ChordSense/ChordSense/docs/AI-rendered-chordsense.png

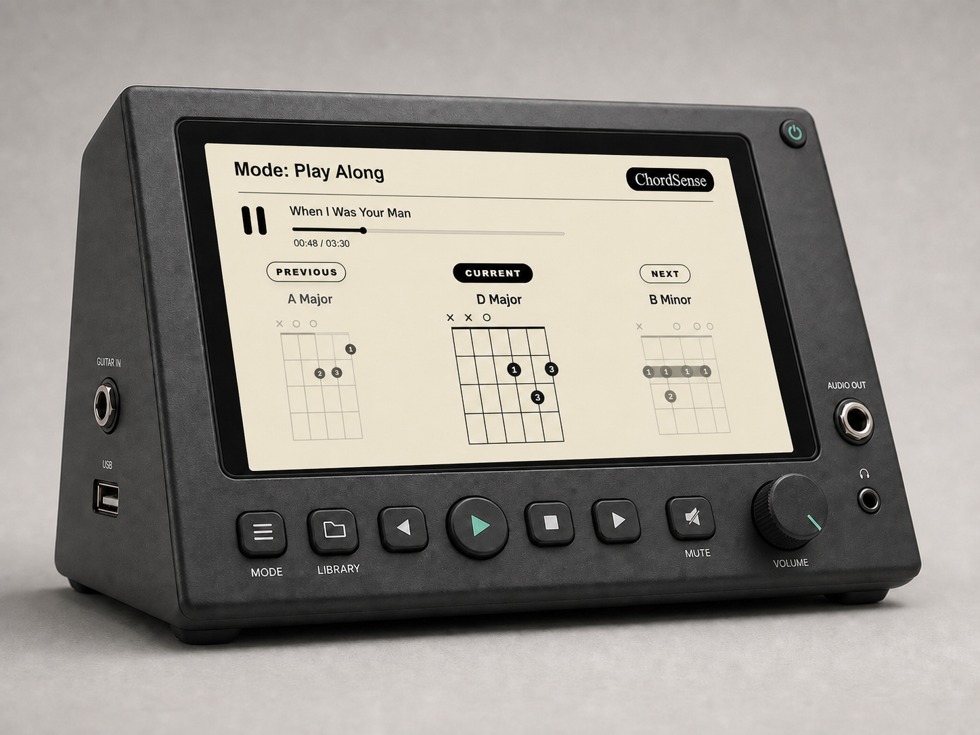
docs/AI-rendered-chordsense.png
