ChordSense/ChordSense/backend/models/chordsense_cnn/notebooks/confusion_matrix.png

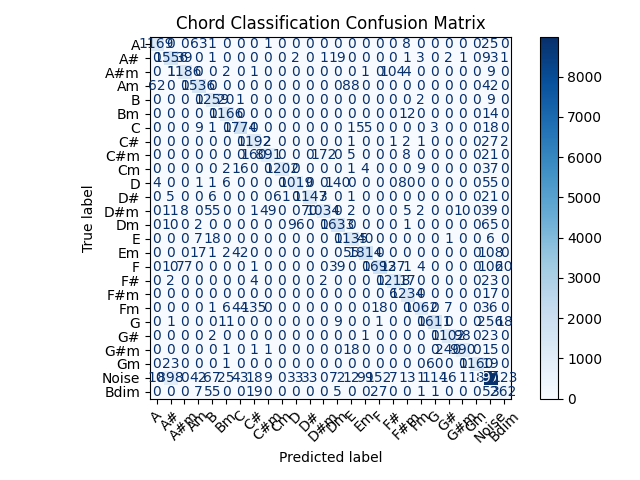
backend/models/chordsense_cnn/notebooks/confusion_matrix.png
