ChordSense/ChordSense/device-ui/src/assets/chords/a.png

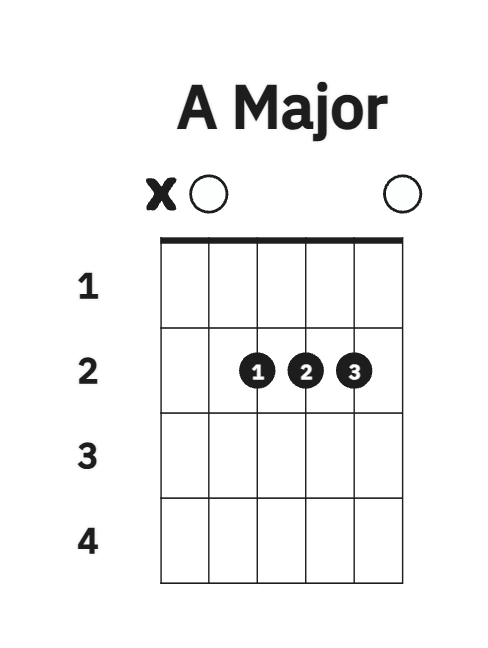
device-ui/src/assets/chords/a.png
