ChordSense/ChordSense/device-ui/src/assets/chords/abmaj7.png

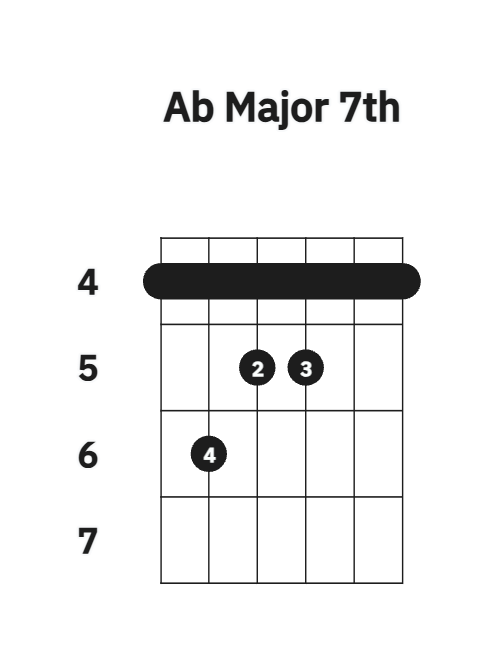
device-ui/src/assets/chords/abmaj7.png
