ChordSense/ChordSense/device-ui/src/assets/chords/b7.png

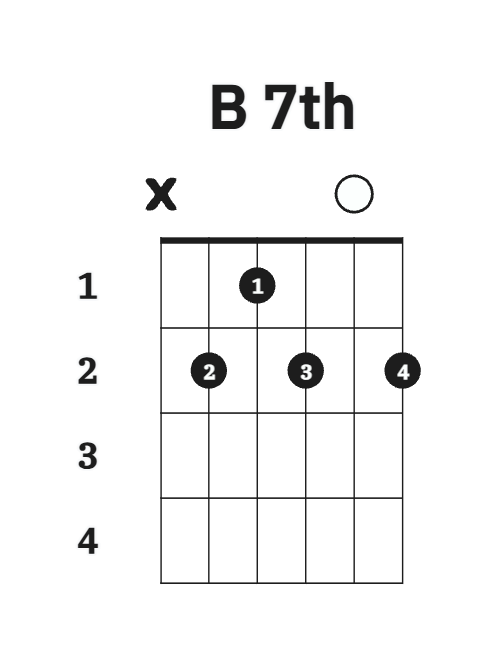
device-ui/src/assets/chords/b7.png
