ChordSense/ChordSense/device-ui/src/assets/chords/bb7.png

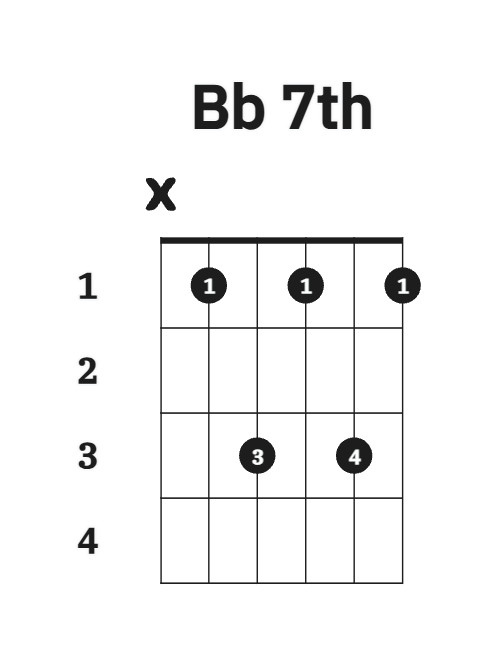
device-ui/src/assets/chords/bb7.png
