ChordSense/ChordSense/device-ui/src/assets/chords/bm.png

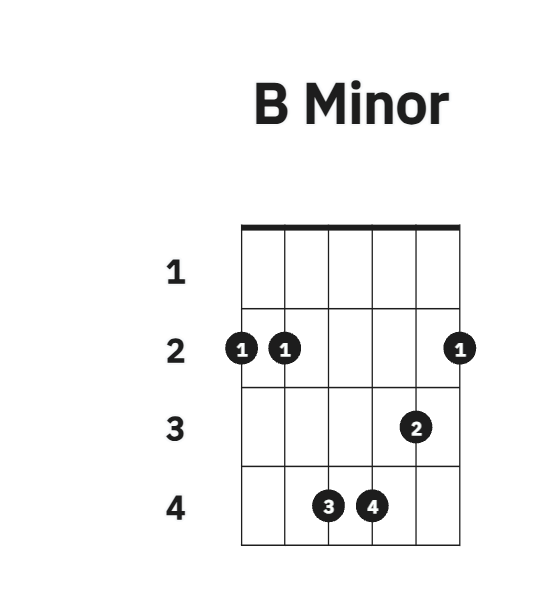
device-ui/src/assets/chords/bm.png
