ChordSense/ChordSense/device-ui/src/assets/chords/c7.png

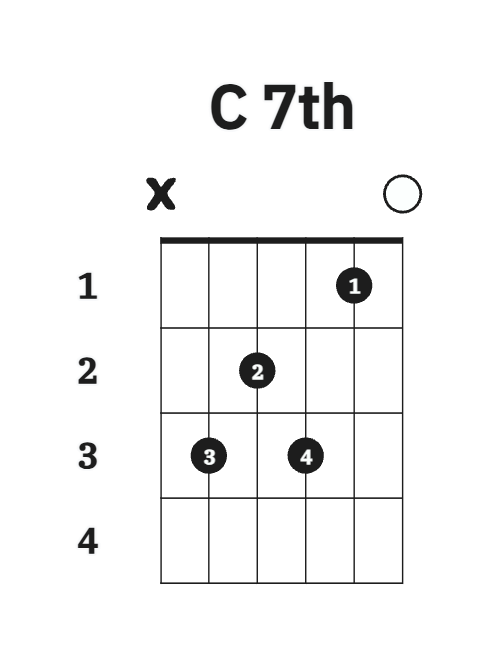
device-ui/src/assets/chords/c7.png
