ChordSense/ChordSense/device-ui/src/assets/chords/csharp.png

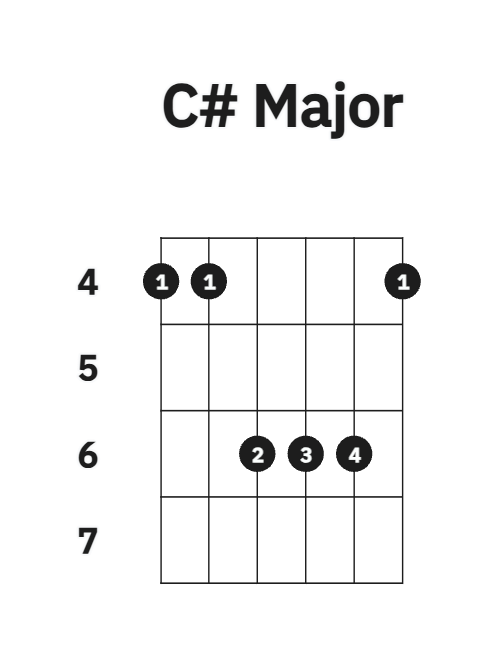
device-ui/src/assets/chords/csharp.png
