ChordSense/ChordSense/device-ui/src/assets/chords/csharpm.png

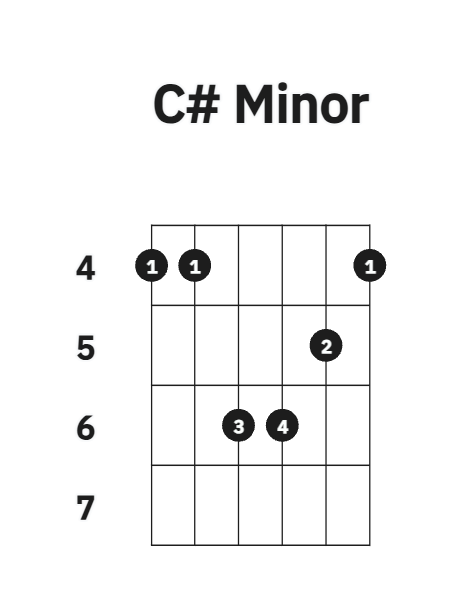
device-ui/src/assets/chords/csharpm.png
