ChordSense/ChordSense/device-ui/src/assets/chords/csharpmaj7.png

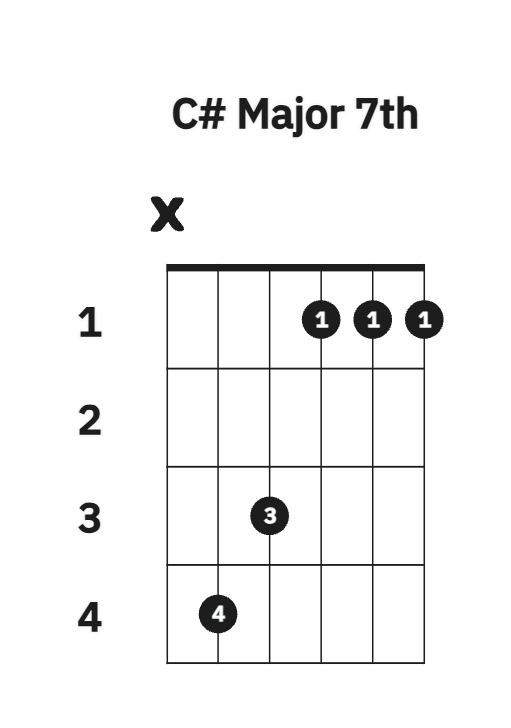
device-ui/src/assets/chords/csharpmaj7.png
