ChordSense/ChordSense/device-ui/src/assets/chords/d7.png

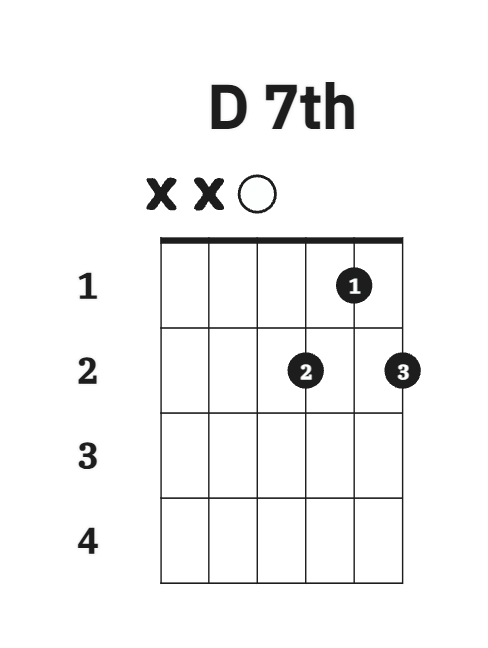
device-ui/src/assets/chords/d7.png
