ChordSense/ChordSense/device-ui/src/assets/chords/dm7.png

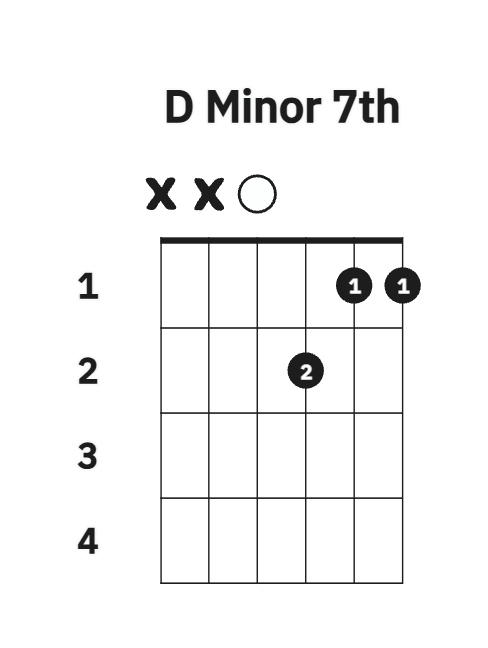
device-ui/src/assets/chords/dm7.png
