ChordSense/ChordSense/device-ui/src/assets/chords/e.png

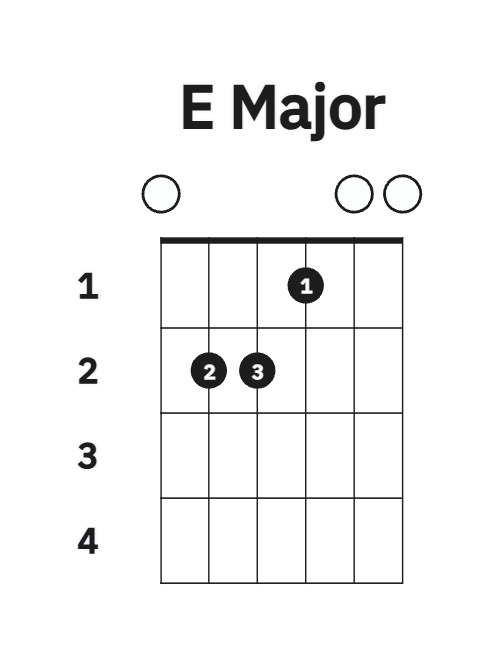
device-ui/src/assets/chords/e.png
