ChordSense/ChordSense/device-ui/src/assets/chords/eb.png

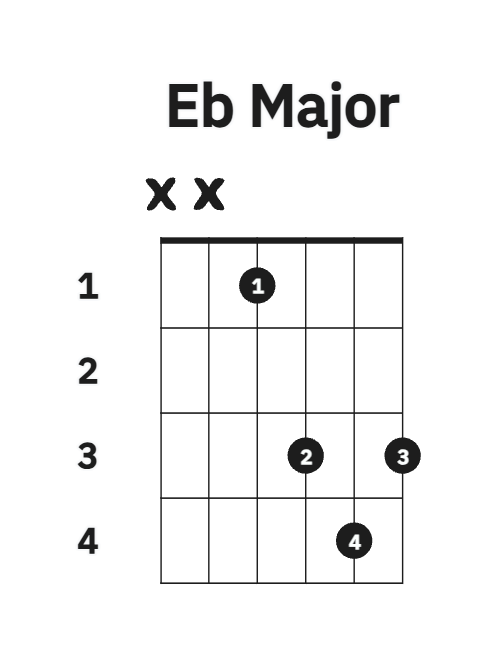
device-ui/src/assets/chords/eb.png
