ChordSense/ChordSense/device-ui/src/assets/chords/ebmaj7.png

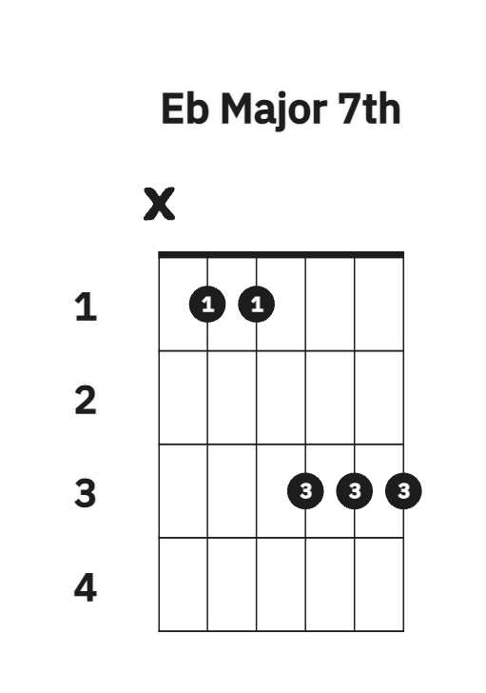
device-ui/src/assets/chords/ebmaj7.png
