ChordSense/ChordSense/device-ui/src/assets/chords/fm.png

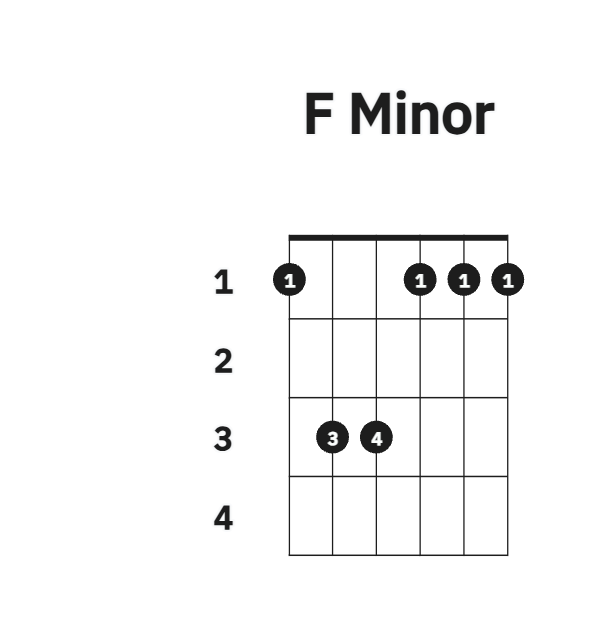
device-ui/src/assets/chords/fm.png
