ChordSense/ChordSense/device-ui/src/assets/chords/fmaj7.png

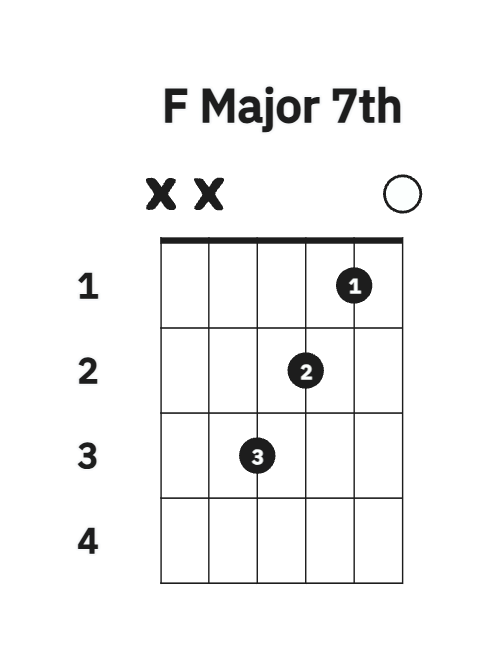
device-ui/src/assets/chords/fmaj7.png
