ChordSense/ChordSense/device-ui/src/assets/chords/g7.png

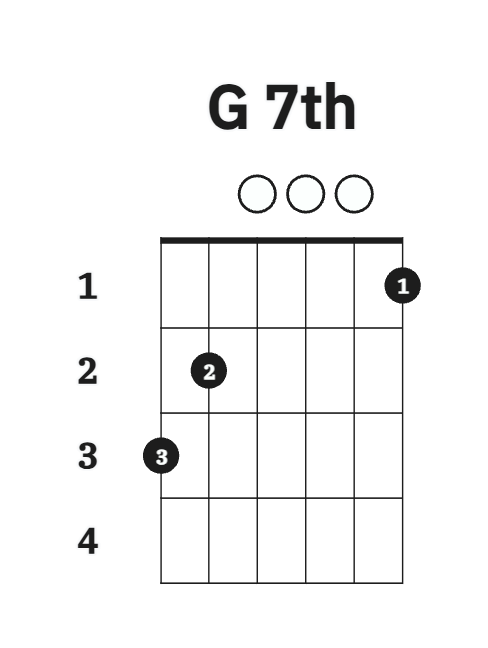
device-ui/src/assets/chords/g7.png
