ChordSense/ChordSense/frontend-tauri/frontend-tauri/src/assets/chords/a7.png

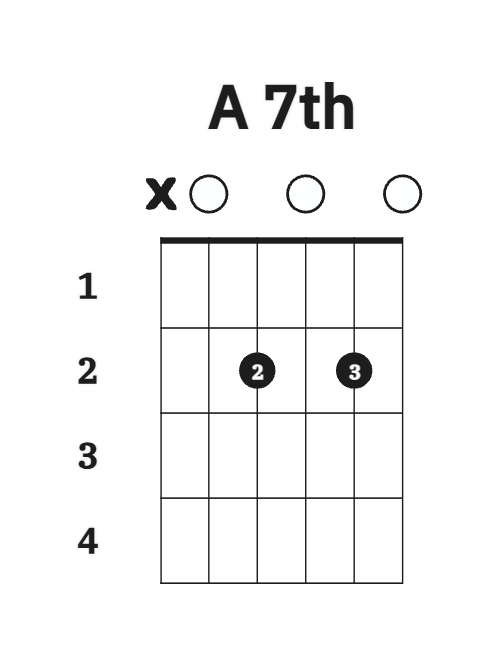
frontend-tauri/frontend-tauri/src/assets/chords/a7.png
