ChordSense/ChordSense/frontend-tauri/frontend-tauri/src/assets/chords/ab7.png

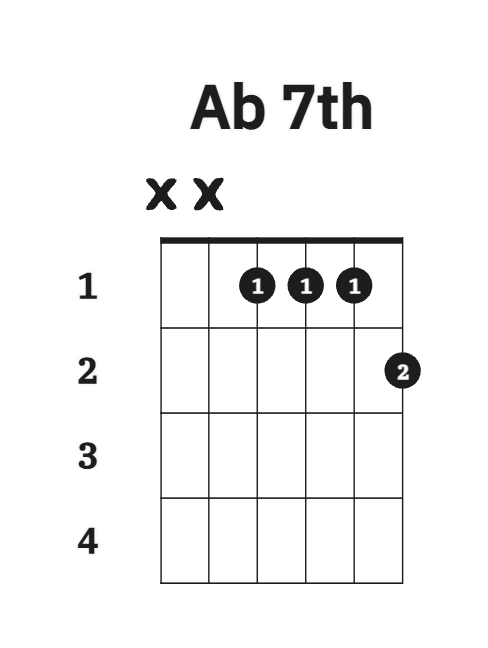
frontend-tauri/frontend-tauri/src/assets/chords/ab7.png
