ChordSense/ChordSense/frontend-tauri/frontend-tauri/src/assets/chords/ab.png

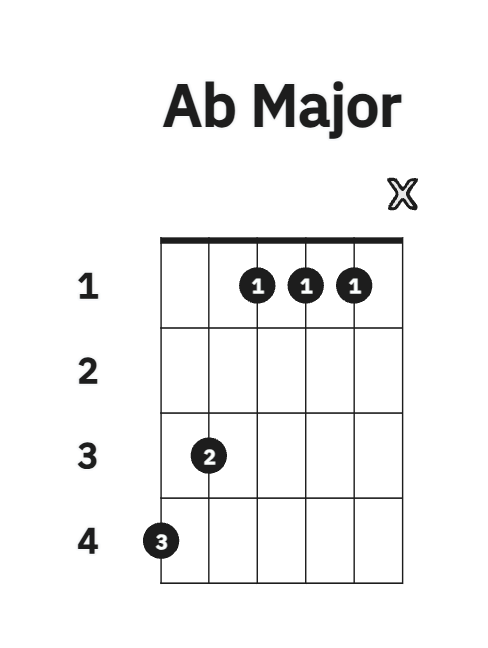
frontend-tauri/frontend-tauri/src/assets/chords/ab.png
