ChordSense/ChordSense/frontend-tauri/frontend-tauri/src/assets/chords/abm7.png

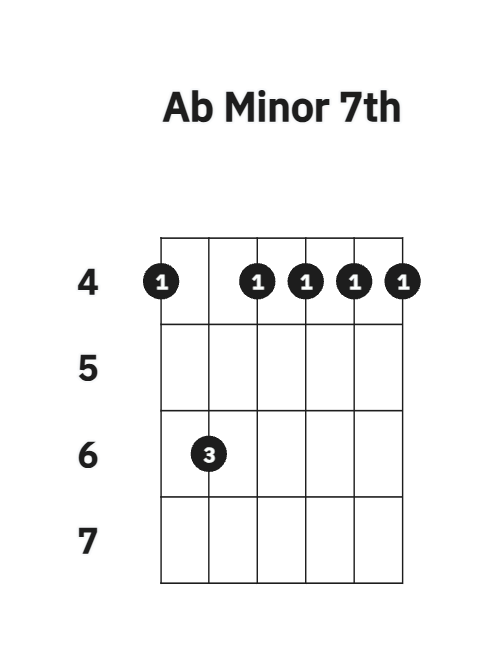
frontend-tauri/frontend-tauri/src/assets/chords/abm7.png
