ChordSense/ChordSense/frontend-tauri/frontend-tauri/src/assets/chords/abm.png

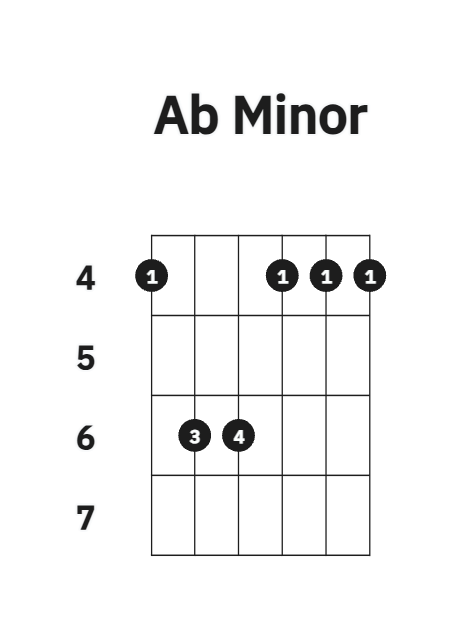
frontend-tauri/frontend-tauri/src/assets/chords/abm.png
