ChordSense/ChordSense/frontend-tauri/frontend-tauri/src/assets/chords/am7.png

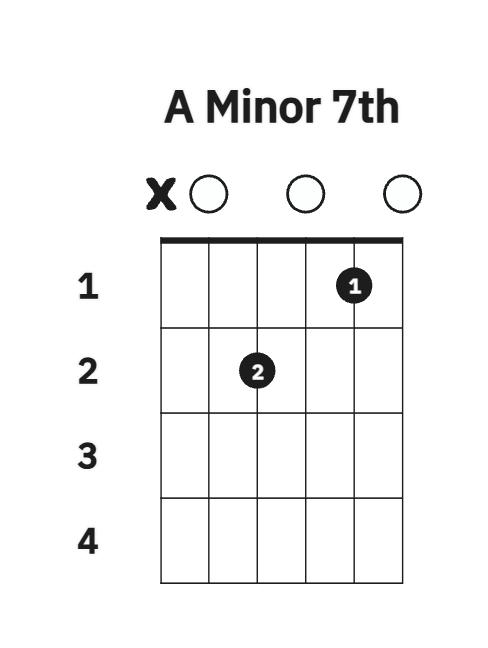
frontend-tauri/frontend-tauri/src/assets/chords/am7.png
