ChordSense/ChordSense/frontend-tauri/frontend-tauri/src/assets/chords/am.png

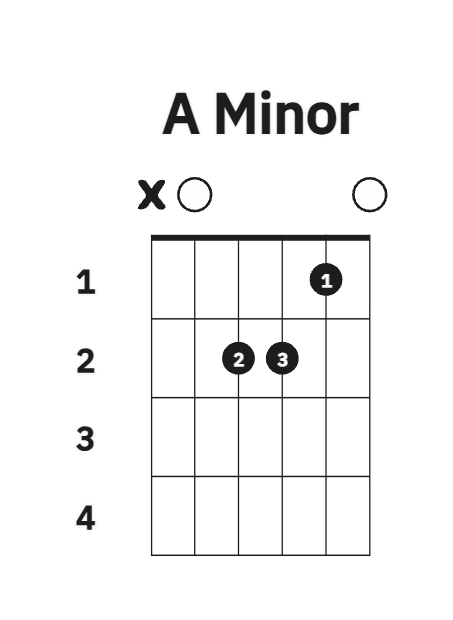
frontend-tauri/frontend-tauri/src/assets/chords/am.png
