ChordSense/ChordSense/frontend-tauri/frontend-tauri/src/assets/chords/amaj7.png

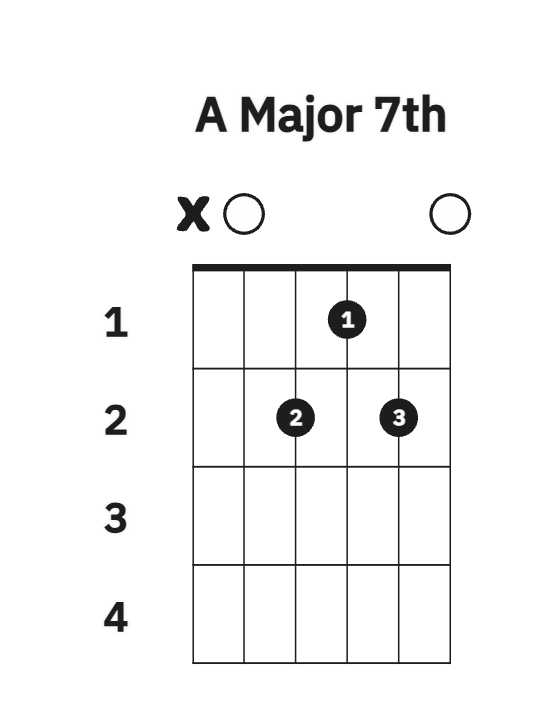
frontend-tauri/frontend-tauri/src/assets/chords/amaj7.png
