ChordSense/ChordSense/frontend-tauri/frontend-tauri/src/assets/chords/b.png

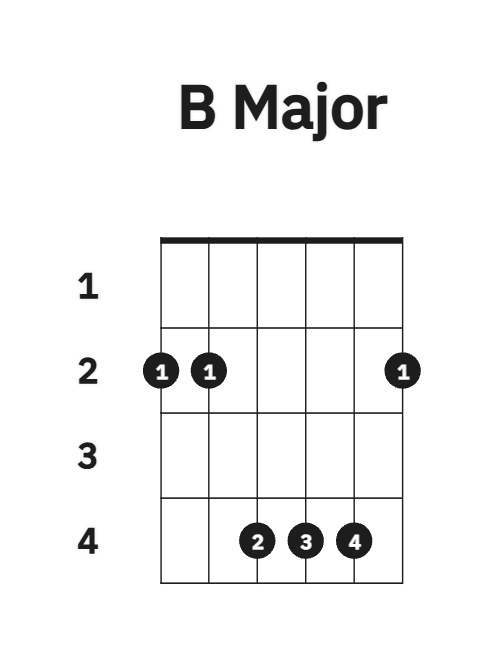
frontend-tauri/frontend-tauri/src/assets/chords/b.png
