ChordSense/ChordSense/frontend-tauri/frontend-tauri/src/assets/chords/bbm7.png

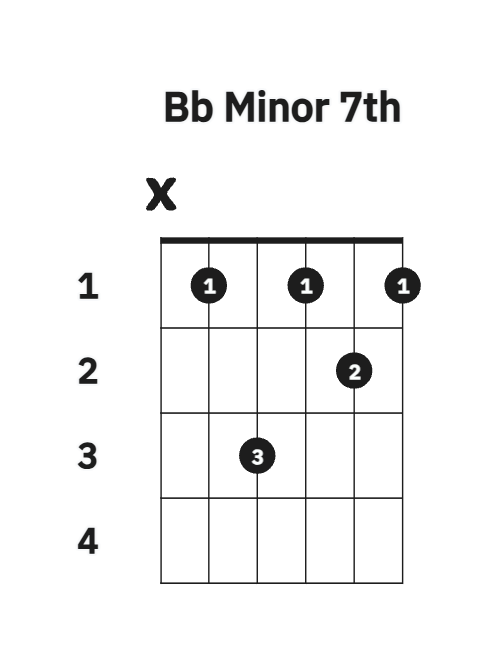
frontend-tauri/frontend-tauri/src/assets/chords/bbm7.png
