ChordSense/ChordSense/frontend-tauri/frontend-tauri/src/assets/chords/bbm.png

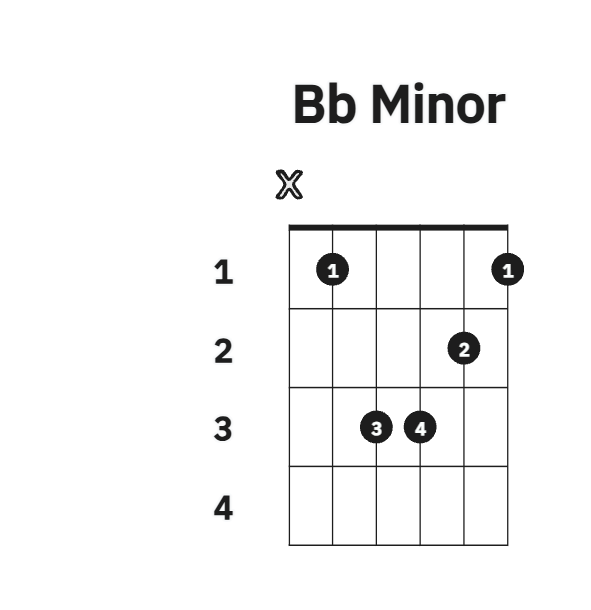
frontend-tauri/frontend-tauri/src/assets/chords/bbm.png
