ChordSense/ChordSense/frontend-tauri/frontend-tauri/src/assets/chords/bm7.png

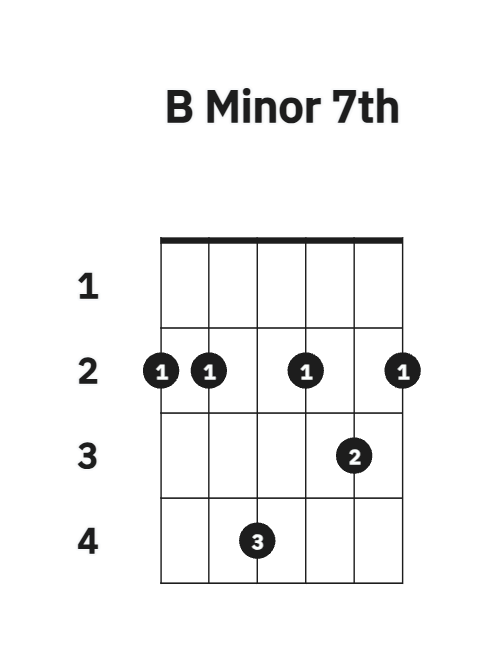
frontend-tauri/frontend-tauri/src/assets/chords/bm7.png
