ChordSense/ChordSense/frontend-tauri/frontend-tauri/src/assets/chords/bmaj7.png

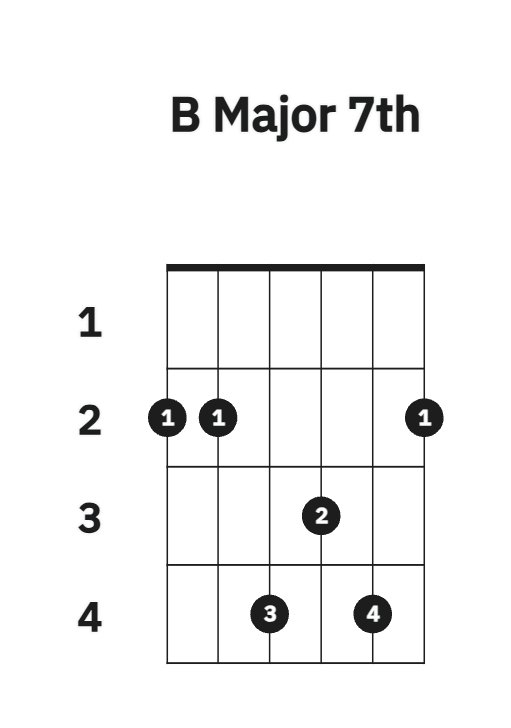
frontend-tauri/frontend-tauri/src/assets/chords/bmaj7.png
