ChordSense/ChordSense/frontend-tauri/frontend-tauri/src/assets/chords/c.png

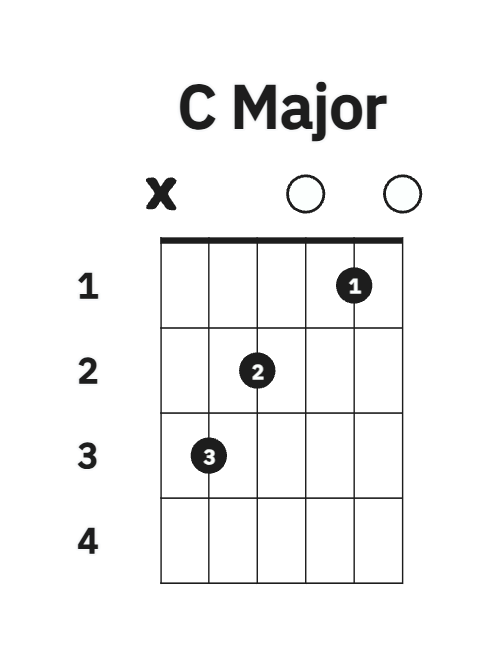
frontend-tauri/frontend-tauri/src/assets/chords/c.png
