ChordSense/ChordSense/frontend-tauri/frontend-tauri/src/assets/chords/cm7.png

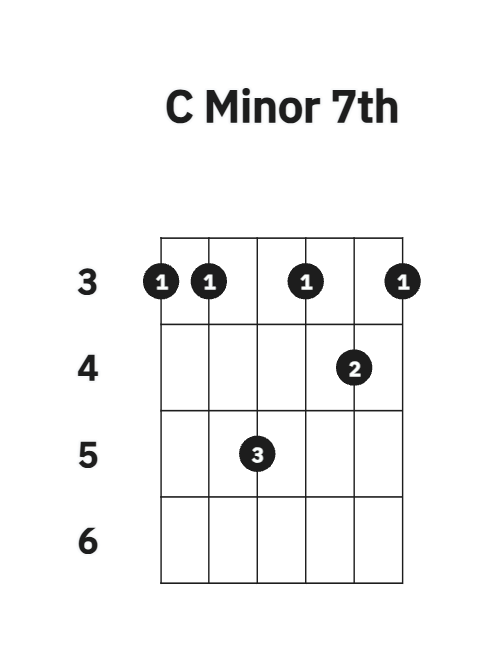
frontend-tauri/frontend-tauri/src/assets/chords/cm7.png
