ChordSense/ChordSense/frontend-tauri/frontend-tauri/src/assets/chords/cm.png

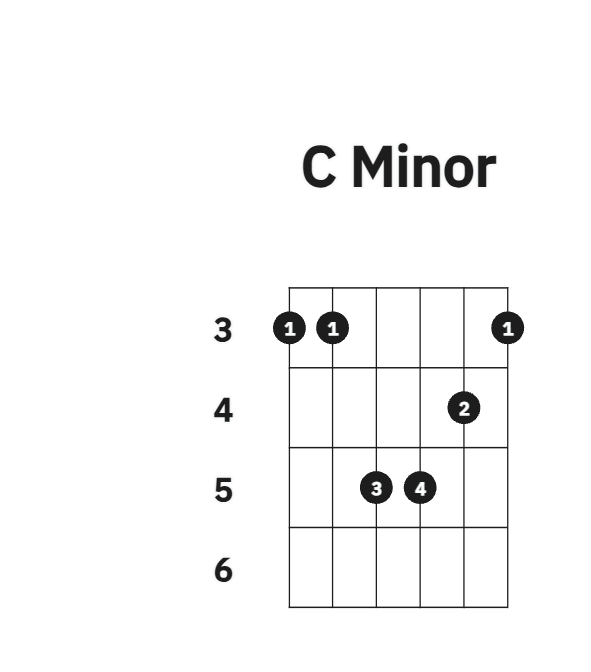
frontend-tauri/frontend-tauri/src/assets/chords/cm.png
