ChordSense/ChordSense/frontend-tauri/frontend-tauri/src/assets/chords/cmaj7.png

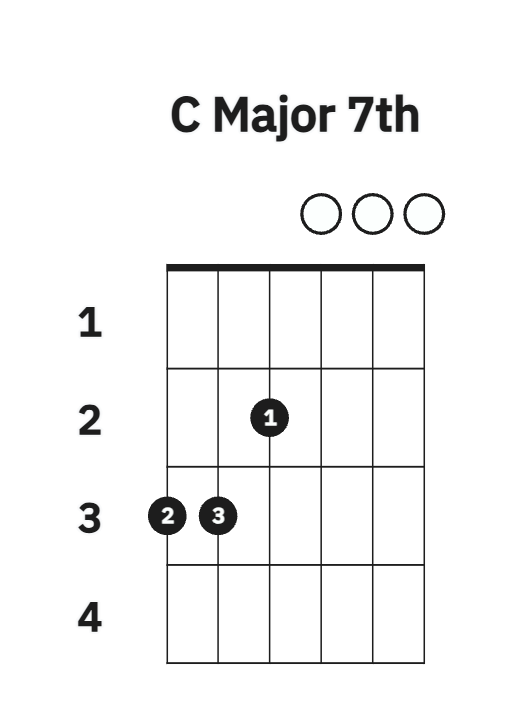
frontend-tauri/frontend-tauri/src/assets/chords/cmaj7.png
