ChordSense/ChordSense/frontend-tauri/frontend-tauri/src/assets/chords/csharp7.png

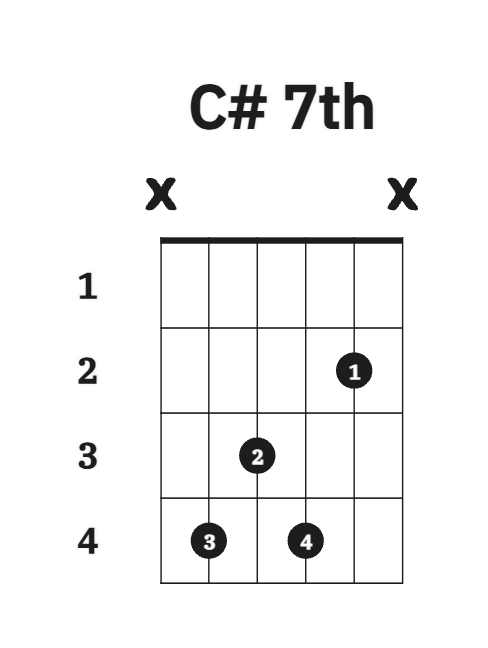
frontend-tauri/frontend-tauri/src/assets/chords/csharp7.png
