ChordSense/ChordSense/frontend-tauri/frontend-tauri/src/assets/chords/csharpm7.png

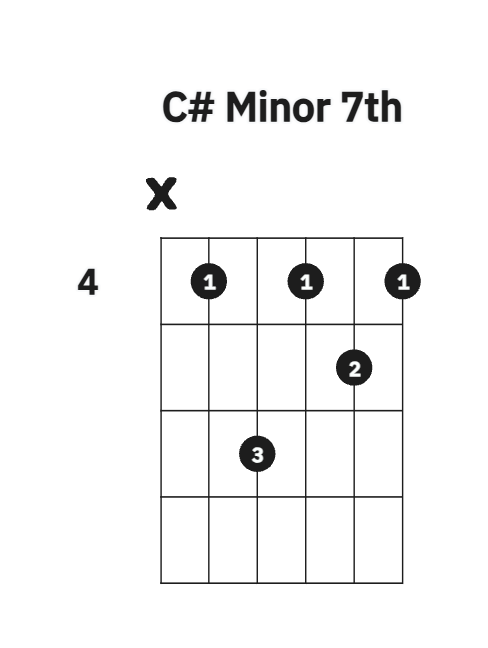
frontend-tauri/frontend-tauri/src/assets/chords/csharpm7.png
