ChordSense/ChordSense/frontend-tauri/frontend-tauri/src/assets/chords/csharpm.png

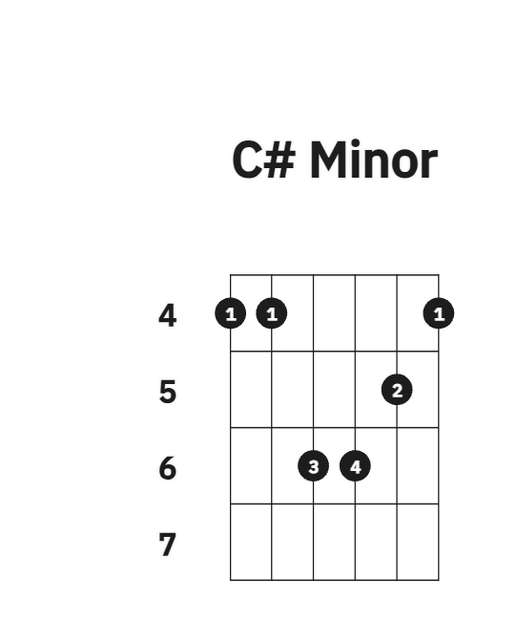
frontend-tauri/frontend-tauri/src/assets/chords/csharpm.png
