ChordSense/ChordSense/frontend-tauri/frontend-tauri/src/assets/chords/dm.png

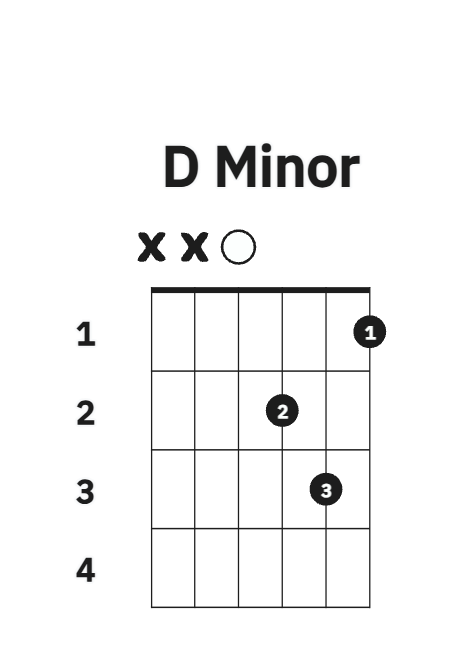
frontend-tauri/frontend-tauri/src/assets/chords/dm.png
