ChordSense/ChordSense/frontend-tauri/frontend-tauri/src/assets/chords/e7.png

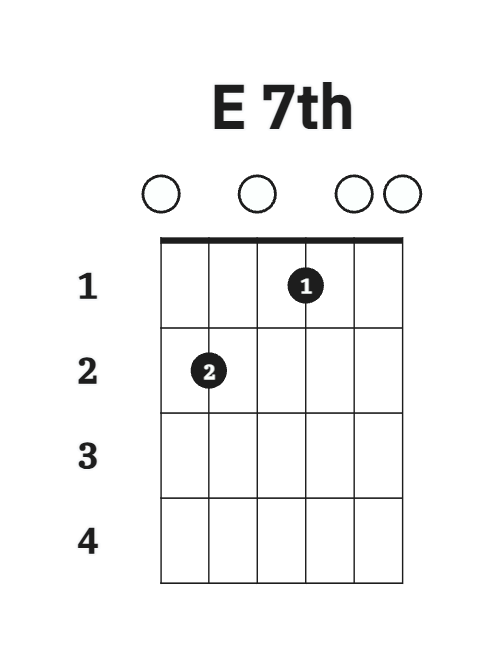
frontend-tauri/frontend-tauri/src/assets/chords/e7.png
