ChordSense/ChordSense/frontend-tauri/frontend-tauri/src/assets/chords/eb7.png

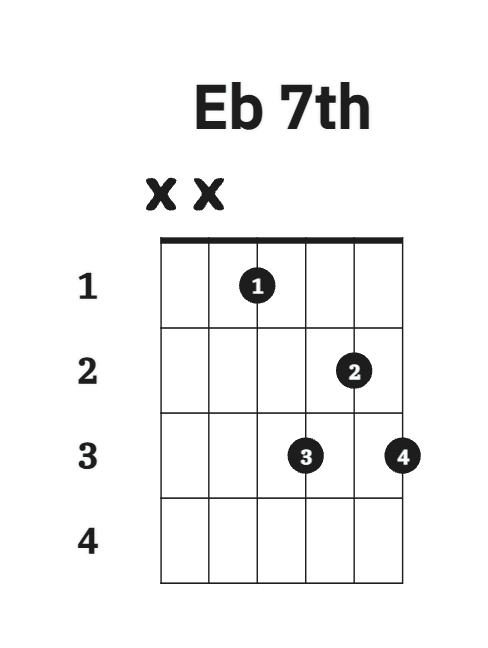
frontend-tauri/frontend-tauri/src/assets/chords/eb7.png
