ChordSense/ChordSense/frontend-tauri/frontend-tauri/src/assets/chords/ebm.png

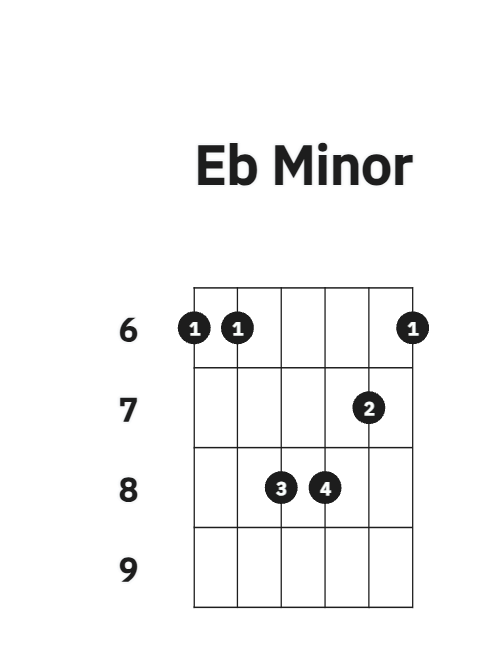
frontend-tauri/frontend-tauri/src/assets/chords/ebm.png
