ChordSense/ChordSense/frontend-tauri/frontend-tauri/src/assets/chords/em.png

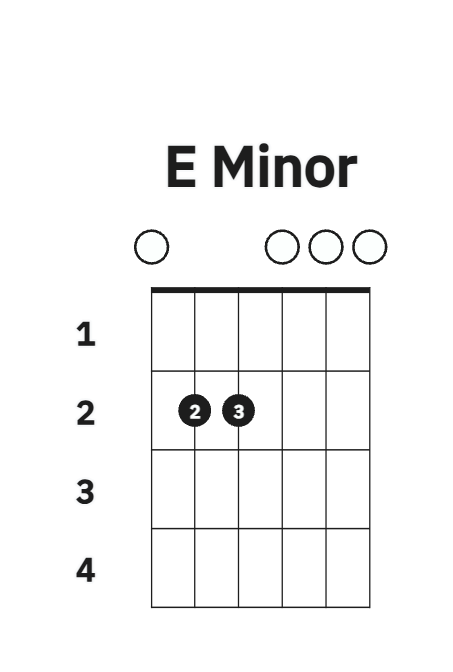
frontend-tauri/frontend-tauri/src/assets/chords/em.png
