ChordSense/ChordSense/frontend-tauri/frontend-tauri/src/assets/chords/f7.png

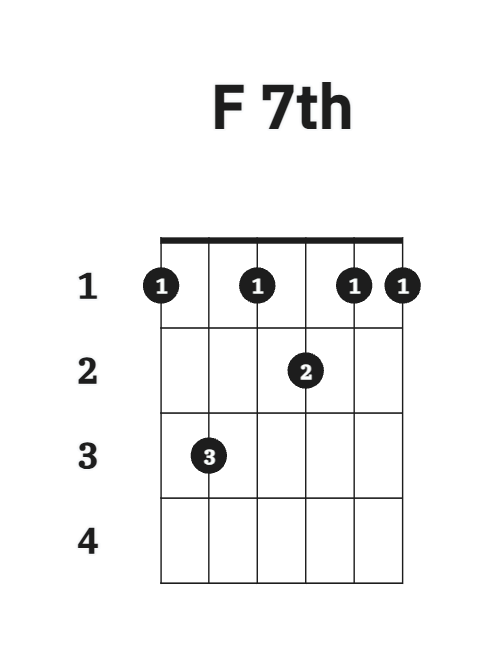
frontend-tauri/frontend-tauri/src/assets/chords/f7.png
