ChordSense/ChordSense/frontend-tauri/frontend-tauri/src/assets/chords/f.png

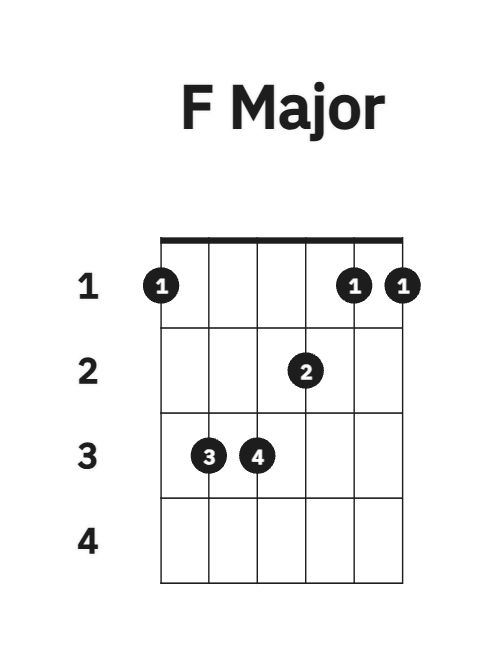
frontend-tauri/frontend-tauri/src/assets/chords/f.png
