ChordSense/ChordSense/frontend-tauri/frontend-tauri/src/assets/chords/fsharp7.png

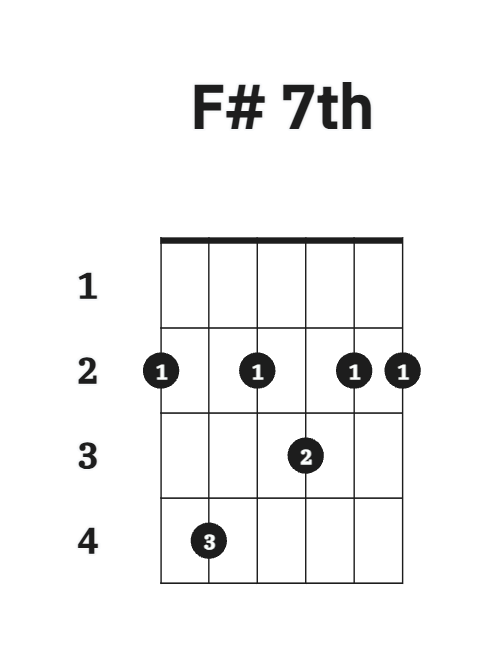
frontend-tauri/frontend-tauri/src/assets/chords/fsharp7.png
