ChordSense/ChordSense/frontend-tauri/frontend-tauri/src/assets/chords/fsharp.png

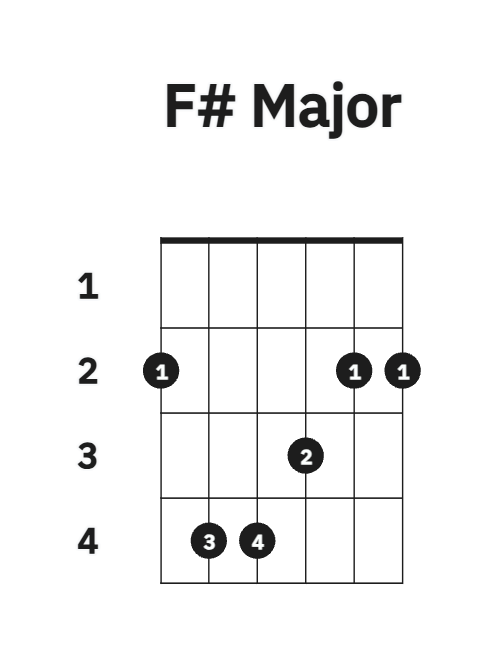
frontend-tauri/frontend-tauri/src/assets/chords/fsharp.png
