ChordSense/ChordSense/frontend-tauri/frontend-tauri/src/assets/chords/fsharpm7.png

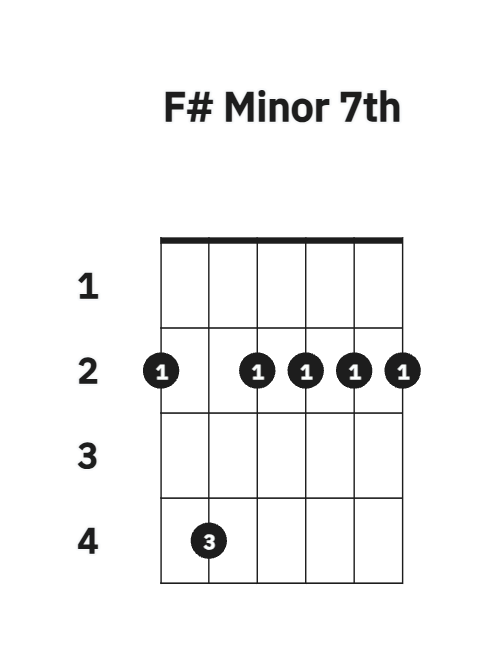
frontend-tauri/frontend-tauri/src/assets/chords/fsharpm7.png
