ChordSense/ChordSense/frontend-tauri/frontend-tauri/src/assets/chords/fsharpm.png

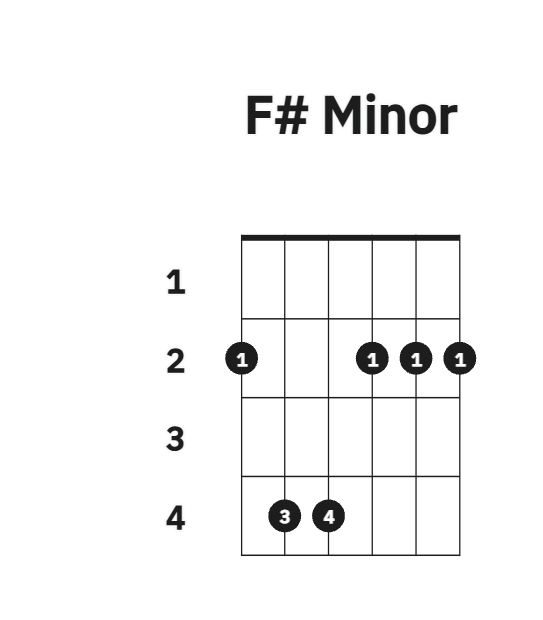
frontend-tauri/frontend-tauri/src/assets/chords/fsharpm.png
