ChordSense/ChordSense/frontend-tauri/frontend-tauri/src/assets/chords/fsharpmaj7.png

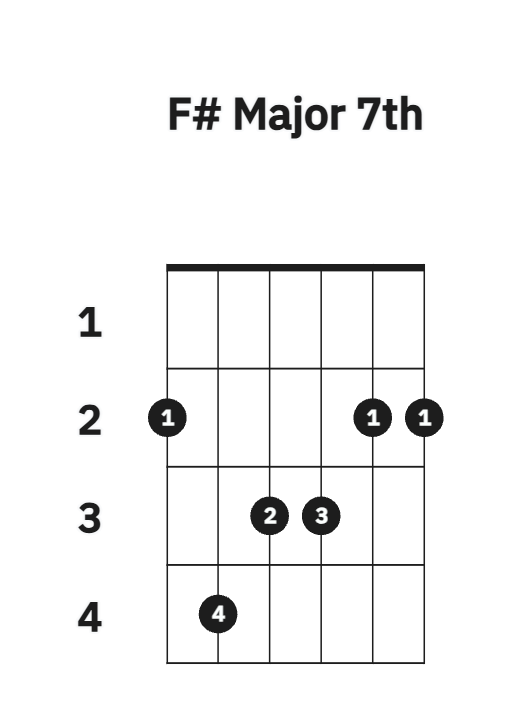
frontend-tauri/frontend-tauri/src/assets/chords/fsharpmaj7.png
