ChordSense/ChordSense/frontend-tauri/frontend-tauri/src/assets/chords/g.png

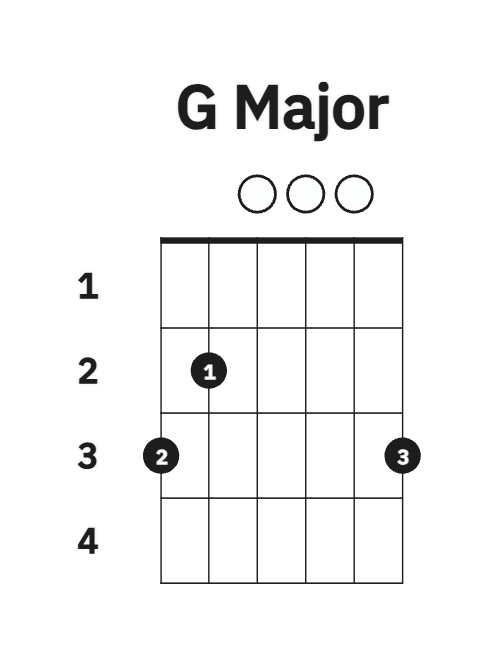
frontend-tauri/frontend-tauri/src/assets/chords/g.png
