ChordSense/ChordSense/frontend-tauri/frontend-tauri/src/assets/chords/gm.png

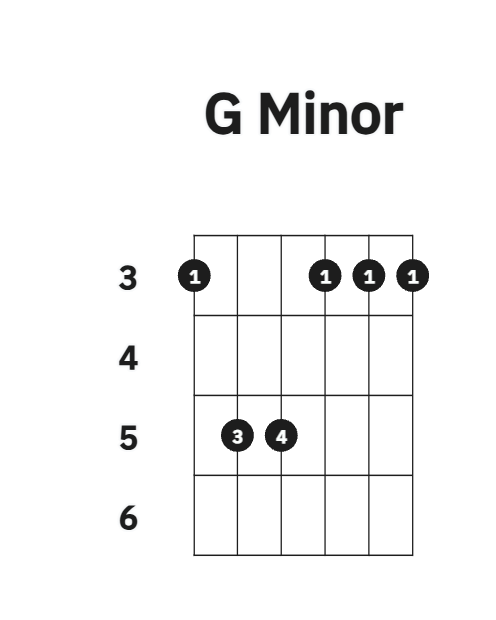
frontend-tauri/frontend-tauri/src/assets/chords/gm.png
