ChordSense/ChordSense/frontend-tauri/frontend-tauri/src/assets/chords/gmaj7.png

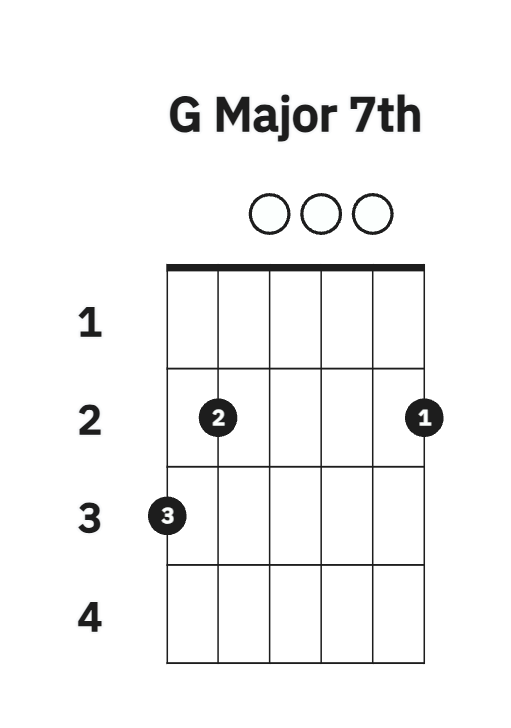
frontend-tauri/frontend-tauri/src/assets/chords/gmaj7.png
