ChordSense/ChordSense/PCB/MCP6002-I_P/3D/MCP6002-I_P.stp

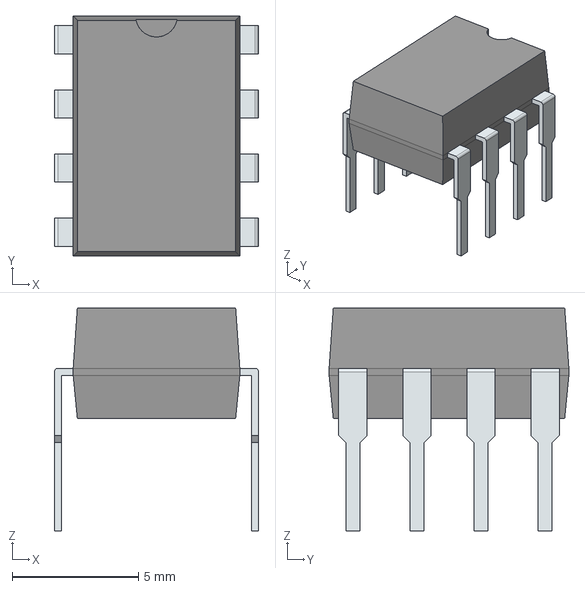
[picture p58: CAD file, 2026-08-26]
PCB/MCP6002-I_P/3D/MCP6002-I_P.stp
8.09 x 9.50 x 8.83 mm
PinsArrayLR
