ChordSense/ChordSense/PCB/PDB182-K425K-103A/eec.models/Bourns_-_PDB182-K425K-103A.step

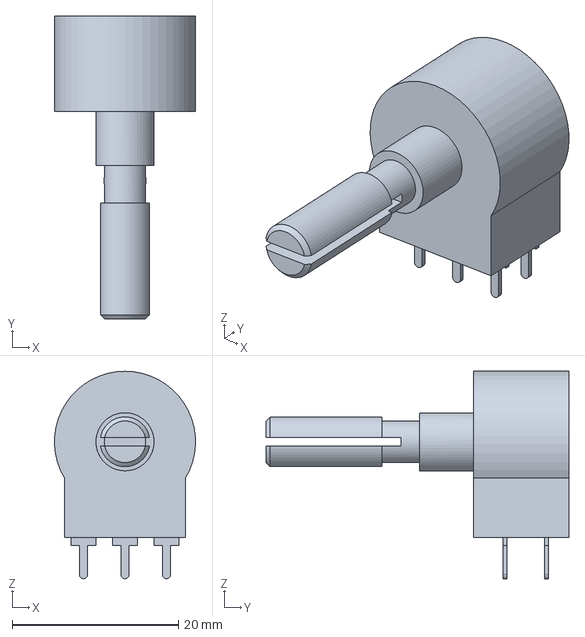
[picture p59: CAD file, 2026-08-26]
PCB/PDB182-K425K-103A/eec.models/Bourns_-_PDB182-K425K-103A.step
17.0 x 36.5 x 25.0 mm
