ChordSense/ChordSense/PCB/SJ3_35053B/SJ3-35053B.step

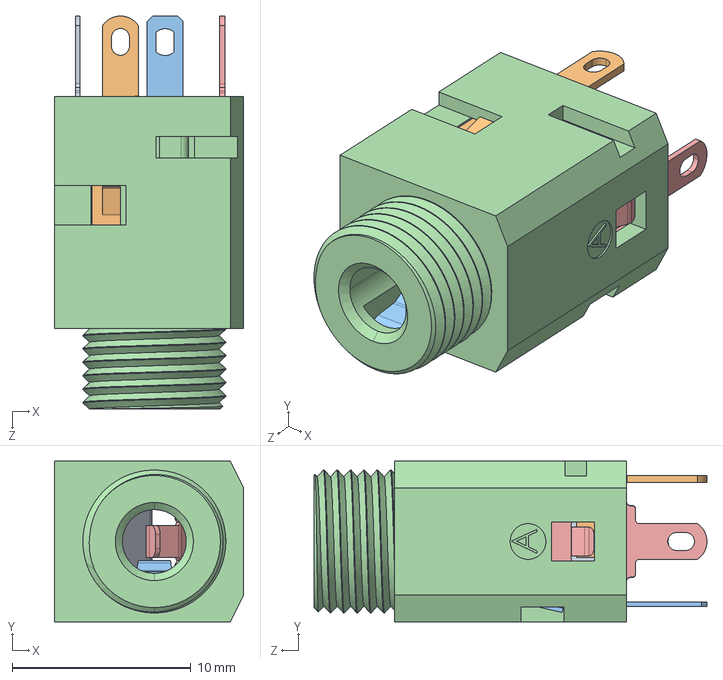
[picture p60: CAD file, 2026-08-26]
PCB/SJ3_35053B/SJ3-35053B.step
10.6 x 9.00 x 22.0 mm
