ChordSense/ChordSense/(list of files, cad)

Other CAD files:
PCB/MCP6002-I_P/Allegro/dip781w56p254l950h533q8n.psm
PCB/MCP6002-I_P/DEHDL/mcp6002_i_p/chips/chips.prt
