ChordSense/ChordSense/Analog/analog_chord_sense.asc

C1: cap; 100nF
C2: cap; 100nF
C3: cap; 100nF
C4: cap; 100nF
R1: res; 22k
R2: res; 100k
R3: res; 5.6k
R4: res; 10k
R5: res; 10k
R6: res; 330k
R7: res; 10k
R8: res; 10k
R9: res; 330k
R11: res; 680000
R12: res; 1000000
R: res; 1000000
U1: UniversalOpAmp2
U2: UniversalOpAmp2
U4: UniversalOpAmp2
V1: voltage; SINE(0 0.5 440)
V2: voltage; 3.3
V3: voltage; SINE(0 1.2 440)
Named nets: in, V+, out1, 0, out2, in2, out3
.tran 0 100ms
