ChordSense/ChordSense/PCB/chordsense_afe/chordsense_afe.kicad_pcb

## KiCad design PCB/chordsense_afe/chordsense_afe.kicad_pcb (2026-08-26)

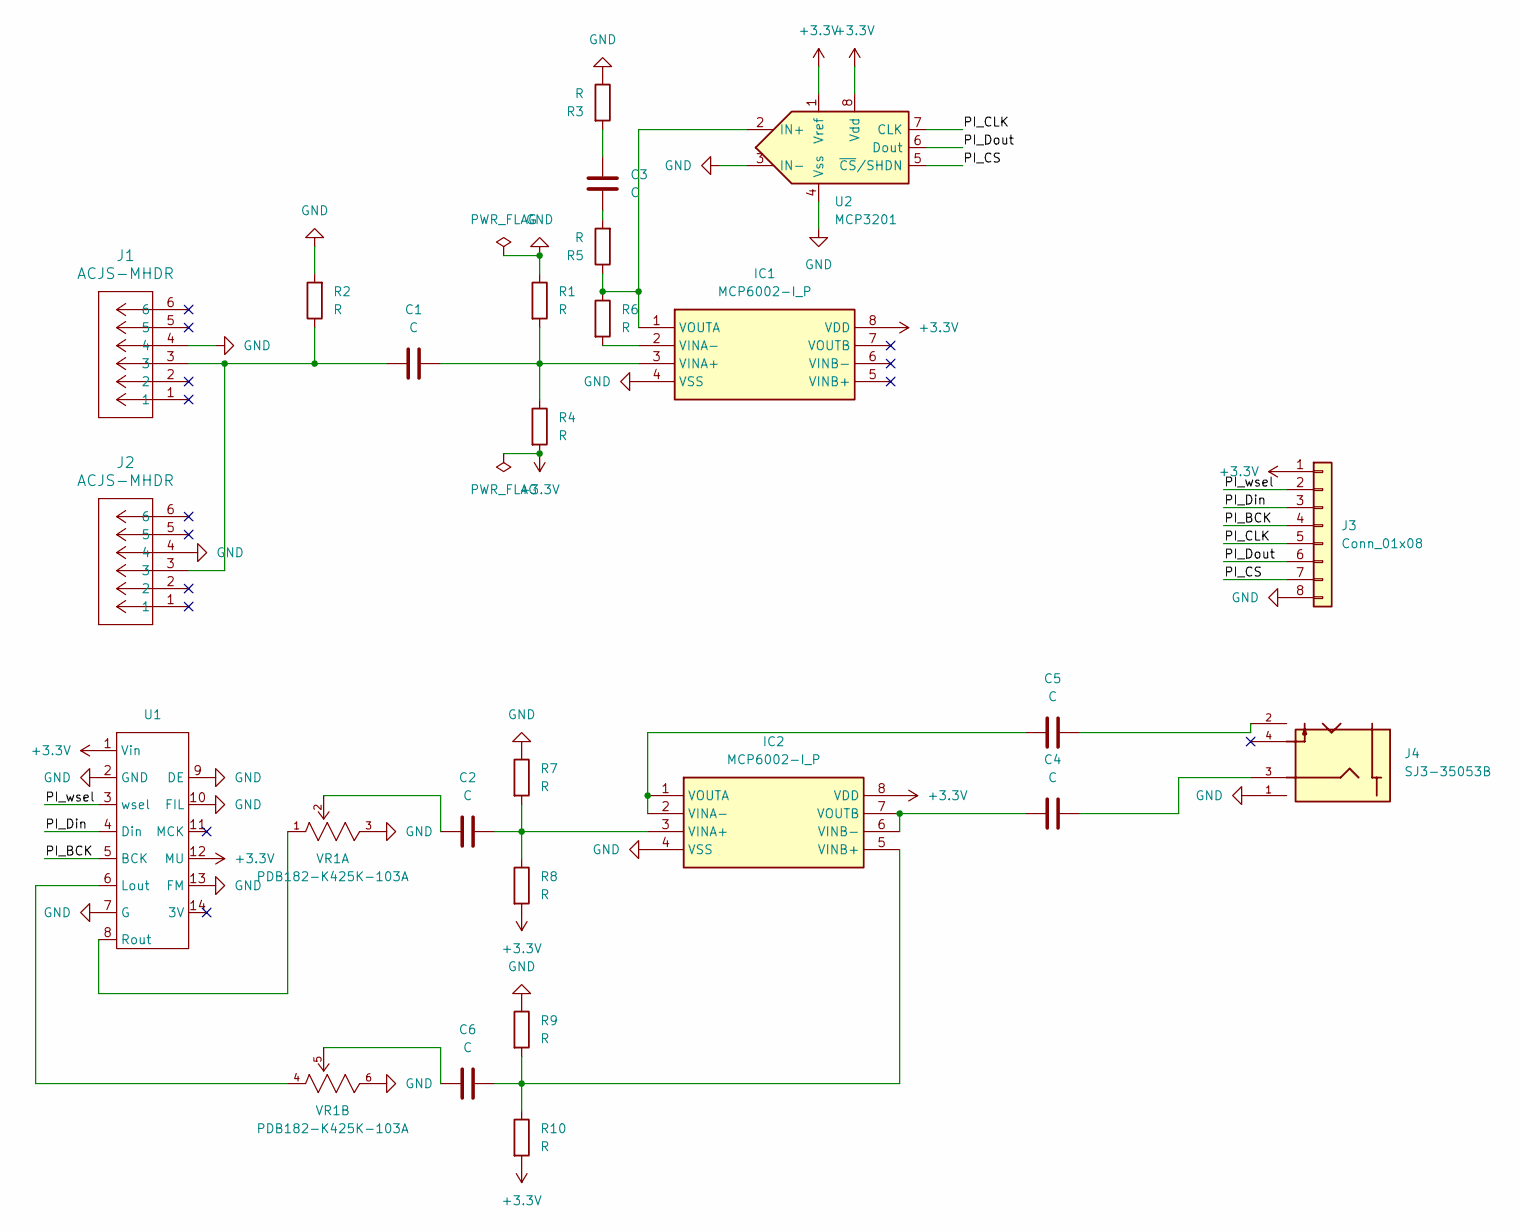
[picture p61: schematic chordsense_afe.kicad_sch]

Parts:
C1, C2, C3, C4, C5, C6: C; C_Disc_D5.0mm_W2.5mm_P5.00mm
IC1, IC2: MCP6002-I_P; DIP781W56P254L950H533Q8N; Manufacturer_Part_Number MCP6002-I/P; Mouser Part Number 579-MCP6002-I/P
J1, J2: ACJS-MHDR; CONN_MHDR_AMP
J3: Conn_01x08; PinHeader_1x08_P2.54mm_Vertical
J4: SJ3-35053B; PinHeader_1x04_P2.54mm_Vertical; PARTREV 1.0
R1, R2, R3, R4, R5, R6, R7, R8, R9, R10: R; R_Axial_DIN0207_L6.3mm_D2.5mm_P10.16mm_Horizontal
U1: DAC
U2: MCP3201; DIP-8_W7.62mm
VR1: PDB182-K425K-103A; PinHeader_1x06_P2.54mm_Vertical; Tolerance ±20%; mouser part number 652-PDB182-K425K103A; digikey description POT 10K OHM 0.06W CARBON LOG

Connections:
+3.3V: IC1.8 (VDD), IC2.8 (VDD), J3.1, R4.2, R8.2, R10.2, U1.1 (Vin), U1.12 (MU), U2.1 (Vref), U2.8 (Vdd)
/PI_BCK: J3.4, U1.5 (BCK)
/PI_CLK: J3.5, U2.7 (CLK)
/PI_CS: J3.7, U2.5 (~CS/SHDN)
/PI_Din: J3.3, U1.4 (Din)
/PI_Dout: J3.6, U2.6 (Dout)
/PI_wsel: J3.2, U1.3 (wsel)
GND: IC1.4 (VSS), IC2.4 (VSS), J1.4, J2.4, J3.8, J4.1, R1.1, R2.2, R3.1, R7.1, R9.1, U1.2 (GND), U1.7 (G), U1.9 (DE), U1.10 (FIL), U1.13 (FM), U2.3 (IN-), U2.4 (Vss), VR1.3 (R1_3), VR1.6 (R2_3)
unnamed: C1.1, J1.3, J2.3, R2.1
unnamed: C3.1, R5.2
unnamed: C3.2, R3.2
unnamed: C4.2, J4.3
unnamed: C5.2, J4.2
unnamed: C1.2, IC1.3 (VINA+), R1.2, R4.1
unnamed: IC1.2 (VINA-), R6.2
unnamed: IC1.1 (VOUTA), R5.1, R6.1, U2.2 (IN+)
unnamed: C2.2, IC2.3 (VINA+), R7.2, R8.1
unnamed: C5.1, IC2.1 (VOUTA), IC2.2 (VINA-)
unnamed: C6.2, IC2.5 (VINB+), R9.2, R10.1
unnamed: C4.1, IC2.6 (VINB-), IC2.7 (VOUTB)
unnamed: U1.6 (Lout), VR1.4 (R2_1)
unnamed: U1.8 (Rout), VR1.1 (R1_1)
unnamed: C2.1, VR1.2 (R1_2)
unnamed: C6.1, VR1.5 (R2_2)

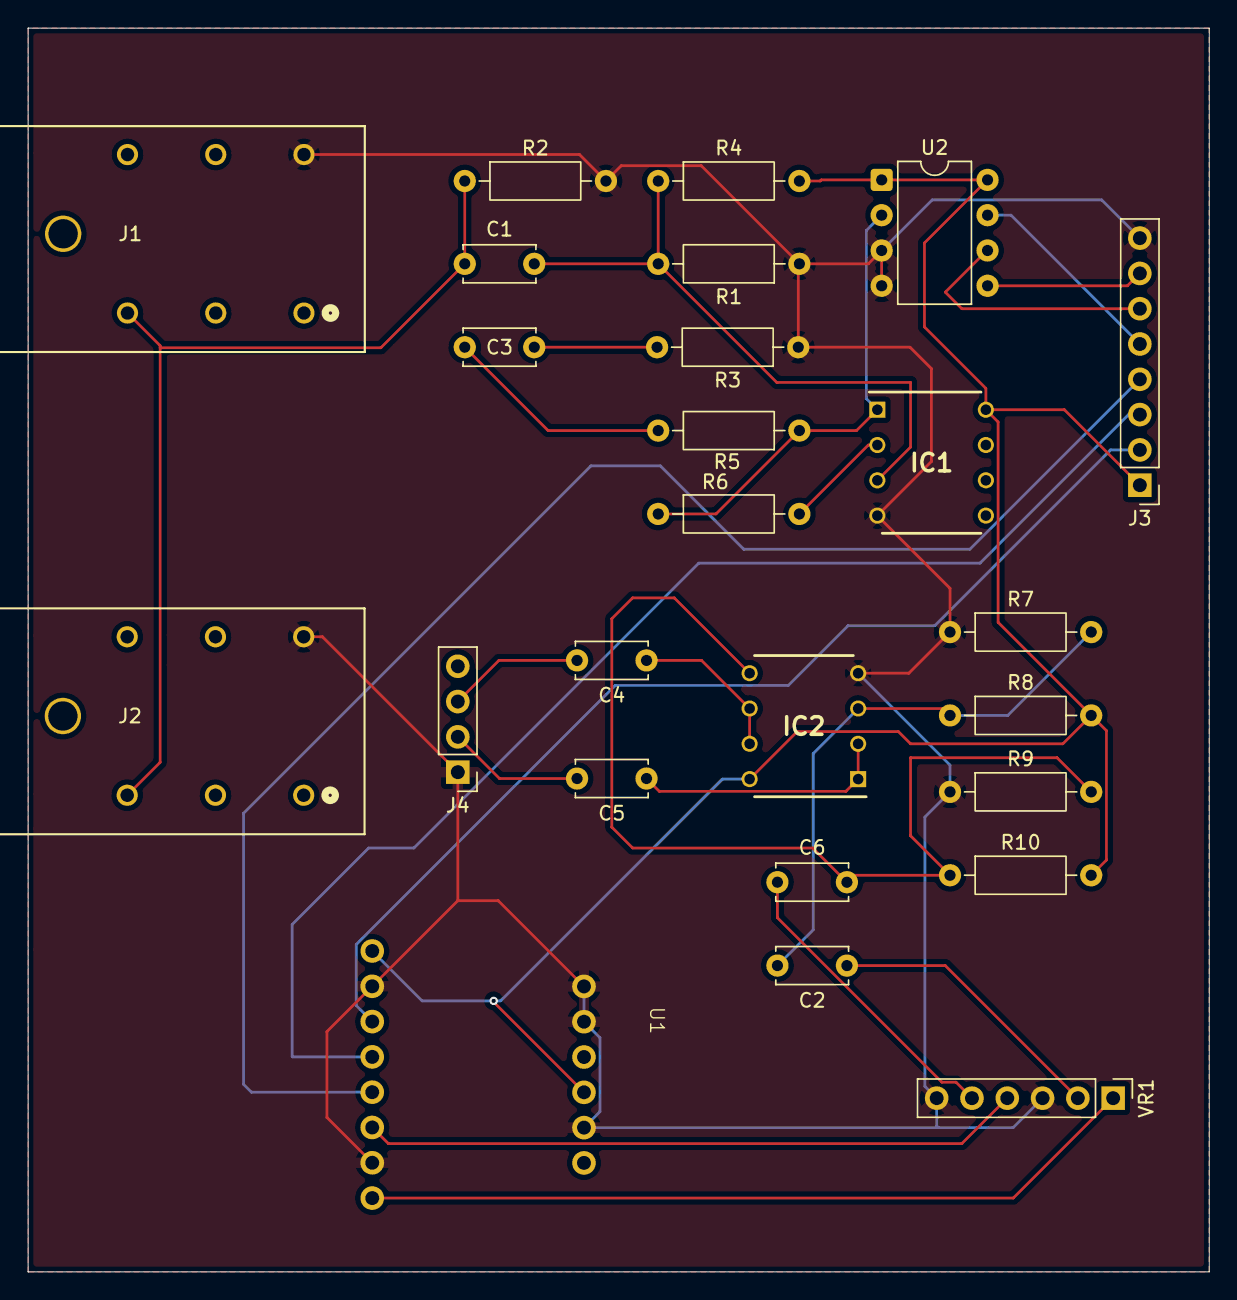
[picture p62: board chordsense_afe.kicad_pcb from above]

Board: 2 copper layers, 85.0 x 89.5 mm, 25 parts (0 on the bottom side), 24 nets.
