ChordSense/ChordSense/(commit log)

2026-04-03 Update README with Jetson installation instructions
    Added instructions for Jetson users to uninstall and install specific versions of packages.
2026-06-21 Designed ui for record mode and is currently set to a dummy .lab file for testing frontend with backend connection.
2026-08-26 PCB schematic contianing main analog circuit and audio jack (with volumn) implemented. Need to route still.
    [Bourns_-_PDB182-K425K-103A.step, EDI2CAP.CFG, MCP6002-I_P.stp, SJ3-35053B.step, chips.prt, chordsense_afe.kicad_pcb, chordsense_afe.kicad_sch, dip781w56p254l950h533q8n.psm]
2026-08-26 initial PCB finished, ready to order remaining parts
    [chordsense_afe.kicad_pcb, chordsense_afe.kicad_sch]
2026-08-27 i/o daemon. allows for continous read of ADC and output of backing track to DAC. CLAUDE HELPED
2026-08-27 allowing for streaming samples in play along mode - CLAUDE HELPED
2026-09-01 refactor(backend): Refactor and cleanup backed
    - Added preprocessing configuration, harmonic separation, resampling, CQT and window generation in audio-preprocessing.py
    - Unified training, dataset loading, file inference and recorded audio inference
    - Unified CQT preprocessing
    - Recording endpoint now passes an AudioBuffer
    - Checkpoint metadata for custom model
    - Early stage regression tests
2026-09-01 UI frontend improvements such as transitions between modes, positioning fixes, and audio playback stopping when switching modes.
2026-09-06 io daemon fixes, claude helped
    [capture.rs, spi.rs, spi_capture_test.rs, spi_freq.rs, spi_probe.rs]
2026-09-06 feat(record): wire live capture through the iod daemon
    Replaces the legacy ESP32 serial path with the iod Unix-socket client so
    Record mode captures real guitar audio on the Pi.
    iod (P2):
    - socket path and captures dir are resolved from env with sane defaults;
    socket falls back to $XDG_RUNTIME_DIR/chordsense-iod.sock (no root
    needed) and the captures dir is absolutized so the wav_path handed back
    over the socket resolves from any working directory
    - Daemon owns captures_dir; capture_path() is a method, not a hardcoded
    relative path
    - run-dev.sh: launch the release binary with those env vars set
    backend (P3):
    - iod_client.py: newline-JSON client over the iod socket; default socket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
    [main.rs, protocol.rs]
2026-09-06 feat(iod): systemd unit for real-time capture + deploy docs
    The daemon already asks for SCHED_FIFO on the sampling thread but a normal
    user can't grant it, so run-dev.sh runs at normal priority and capture
    starves under desktop load. Add a system service that fixes this and
    makes iod a real appliance.
    - iod/deploy/chordsense-iod.service: runs as `chordsense` with
    CPUSchedulingPolicy=fifo + LimitRTPRIO (PID 1 sets the policy before
    exec; the rlimit lets the in-process call succeed too), RuntimeDirectory
    for the socket, Restart=on-failure, and light sandboxing that still
    allows spidev + ALSA.
    - iod/deploy/chordsense-iod.env: shared socket/captures/spidev config,
    sourceable before st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
    [capture.rs]
2026-09-06 feat(record): play the recorded take back in sync
    A finished recording showed its chord diagrams frozen: loadRecordedAnalysis()
    cleared the <audio> element and nulled state.audioPath, so there was no audio
    and the transport controls stayed inert.
    - lib.rs: add wav_path to AnalyzeResponse. The backend has been sending it
    since /end_recording moved onto iod, but serde was dropping it.
    - play-along.js: loadRecordedAnalysis() is async and loads the captured WAV
    through the existing load_audio_file command (Blob -> audio.src), the same
    path Sense mode uses for a picked file. Setting state.audioPath re-enables
    play/pause/stop/seek, and chord roll-through already keys off
    audio.currentTi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
2026-09-08 Added Track Library Popup for browsing between uploaded songs from the webapp.
2026-09-10 record mode timer fix
2026-09-20 pitch aware architecture test
2026-09-30 Release Hailo device after recording analysis
2026-10-11 Sleep ADC sampler outside recording and live feedback
2026-10-11 Keep recording stops responsive during ADC reads
2026-10-12 web app separation and wifi device pairing
2026-10-25 pcb fixes (wider holds for acjs)
2026-10-28 Replace device UI with native Rust
